RonAaron61/MyEIT-V1.1/(threads)

Thread 1 (2025-07-10):

I followed the tutorial but was unsuccessful.

Lemon-Ye, 2025-07-10:
After soldering the circuit board, run the code and obtain the result without any objects in the water：
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

It should be a problem with the circuit board, but I checked and soldered the second one, and the same result was obtained.

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
