RonAaron61/MyEIT-V1.1/assets/PCB/EIT_Micro-V1.1.pdf

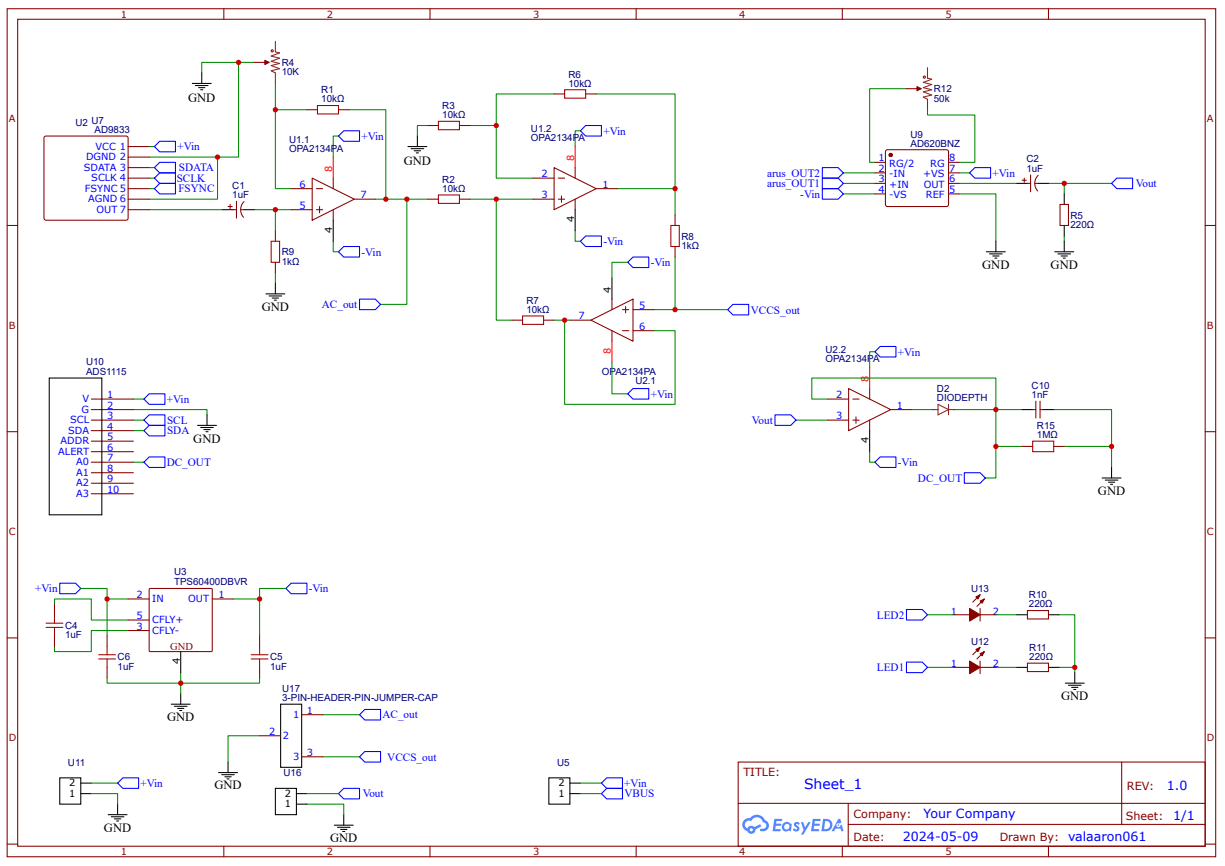
[picture p15: page 1]

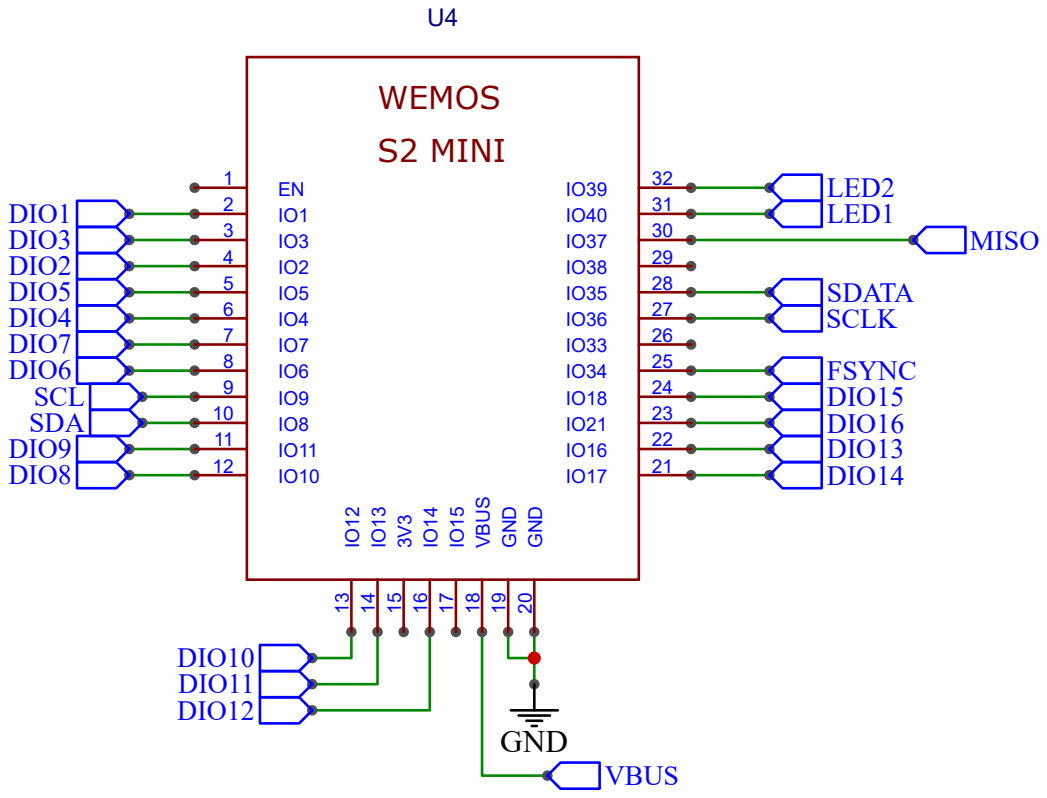
[picture p16: page 2]
TITLE:; Sheet_2; REV: 1.0; DIO16; MISO; LED2; DIO15; DIO14; DIO13; DIO12; DIO11; DIO10; DIO9 DIO8; DIO7 DIO6; DIO5 DIO4; DIO3 DIO2; DIO1; VBUS; LED1; FSYNC; SCLK; SDATA; GND; SCL SDA; WEMOS S2 MINI

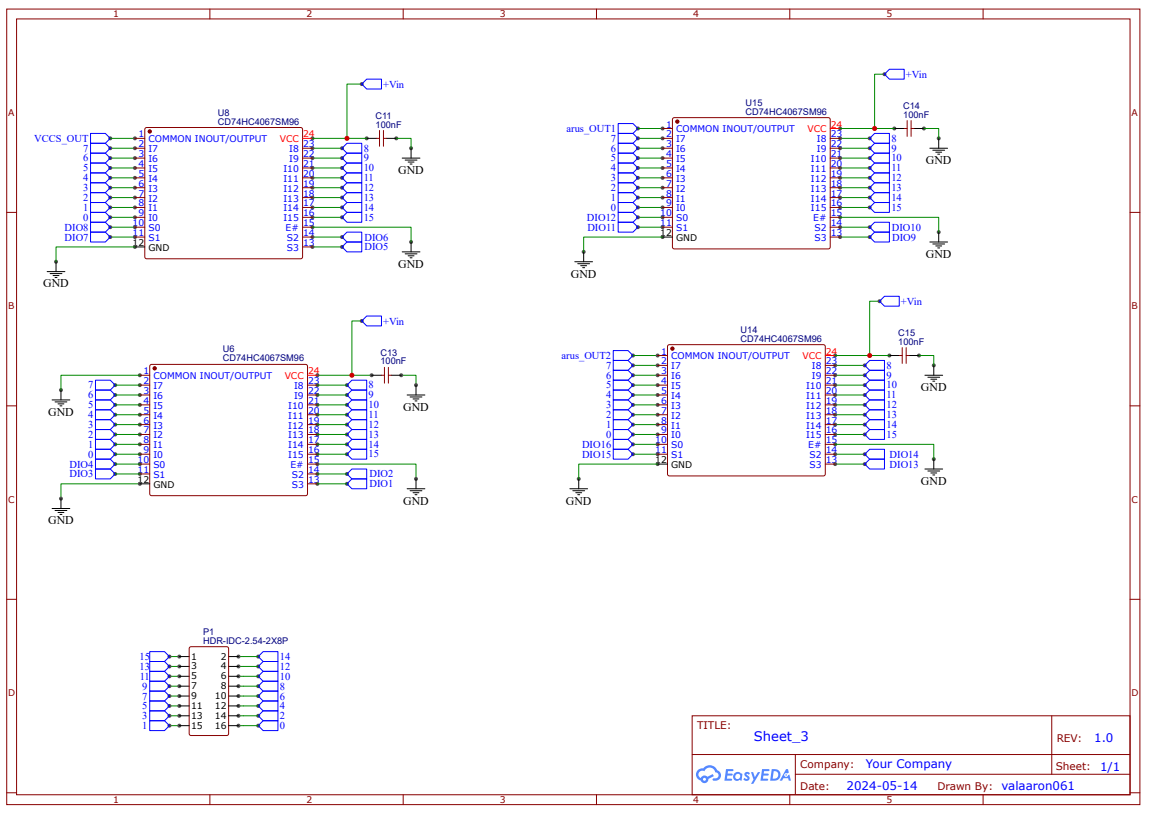
[picture p17: page 3]
